nguyentrongkhoa/H-Andy/Pictures/compliant_finger_8.png

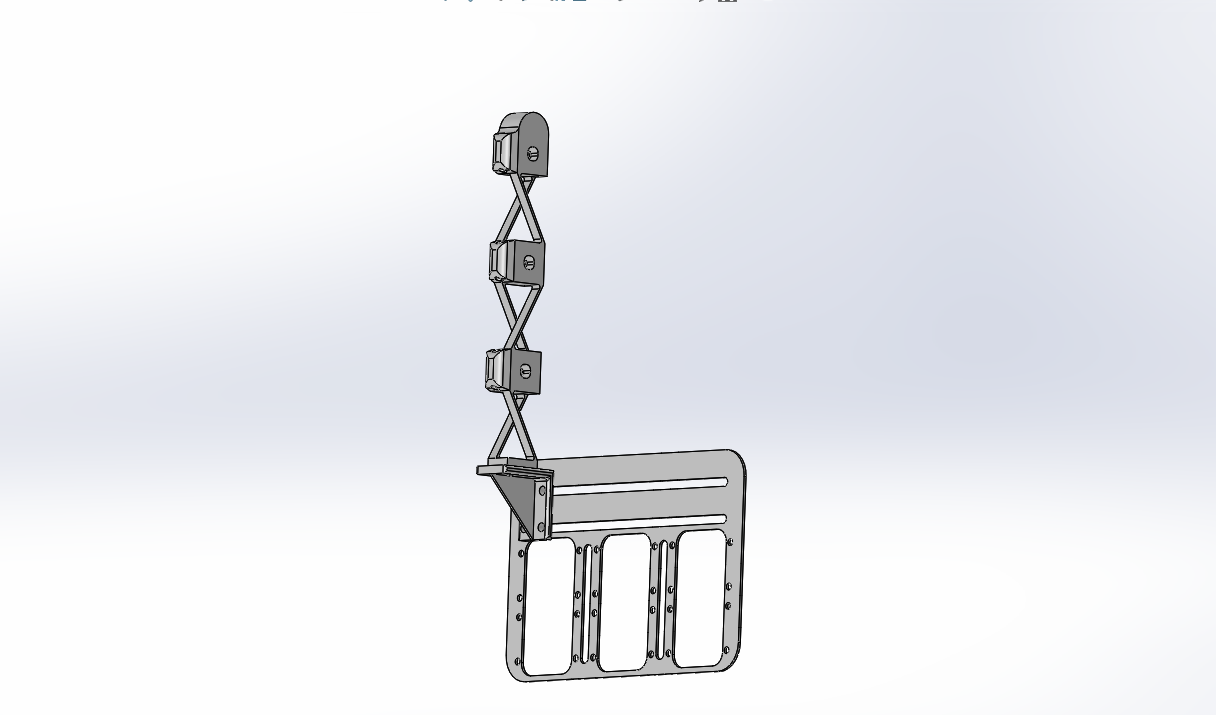
Pictures/compliant_finger_8.png
