nguyentrongkhoa/H-Andy/Pictures/finger_18.05.png

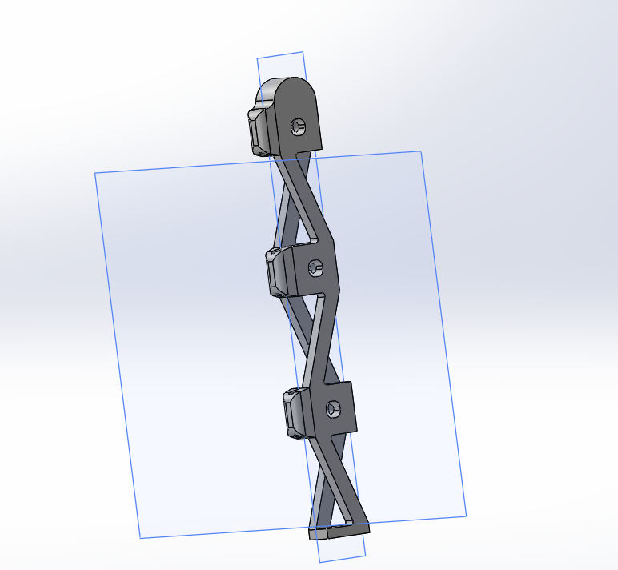
Pictures/finger_18.05.png
