nguyentrongkhoa/H-Andy/Pictures/hand_18.05.png

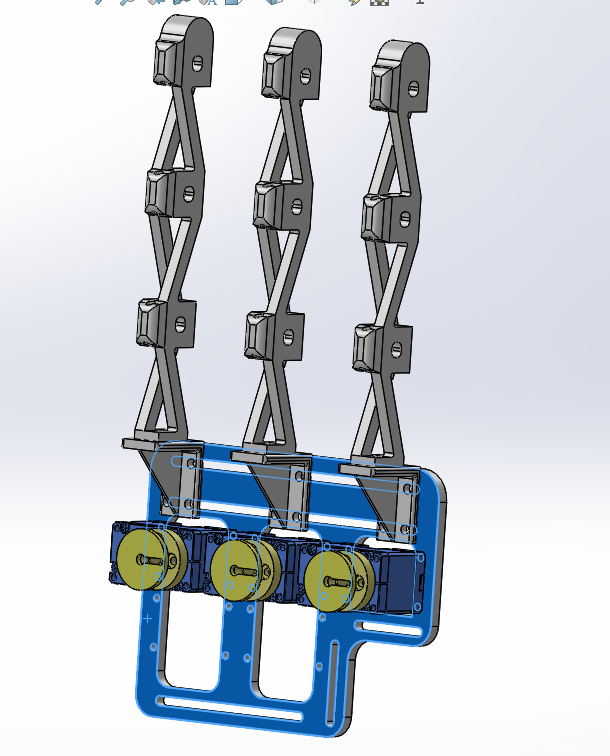
Pictures/hand_18.05.png
