nguyentrongkhoa/H-Andy/Pictures/palm_18.05.png

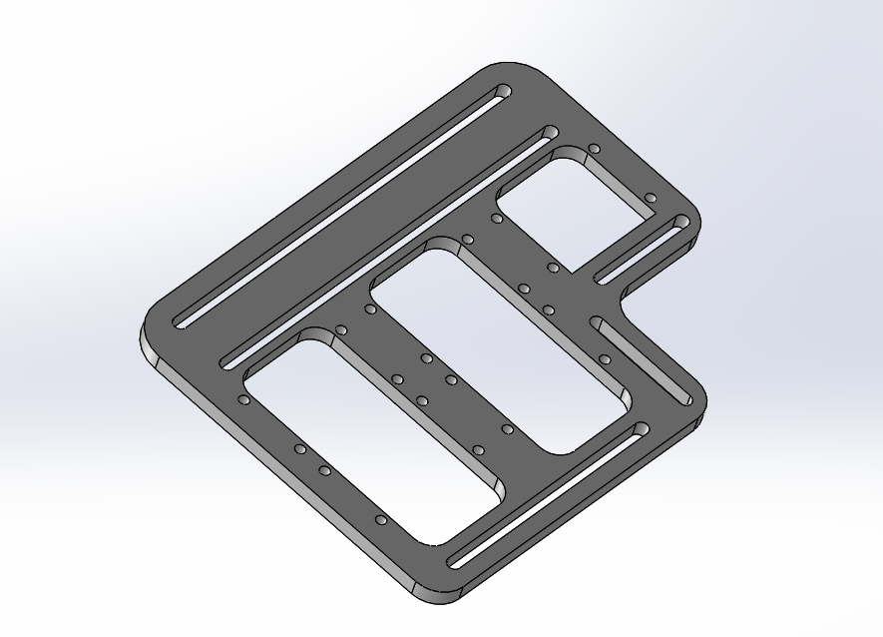
Pictures/palm_18.05.png
