nguyentrongkhoa/H-Andy/U2D2_Powerhub  Gehäuse.SLDASM

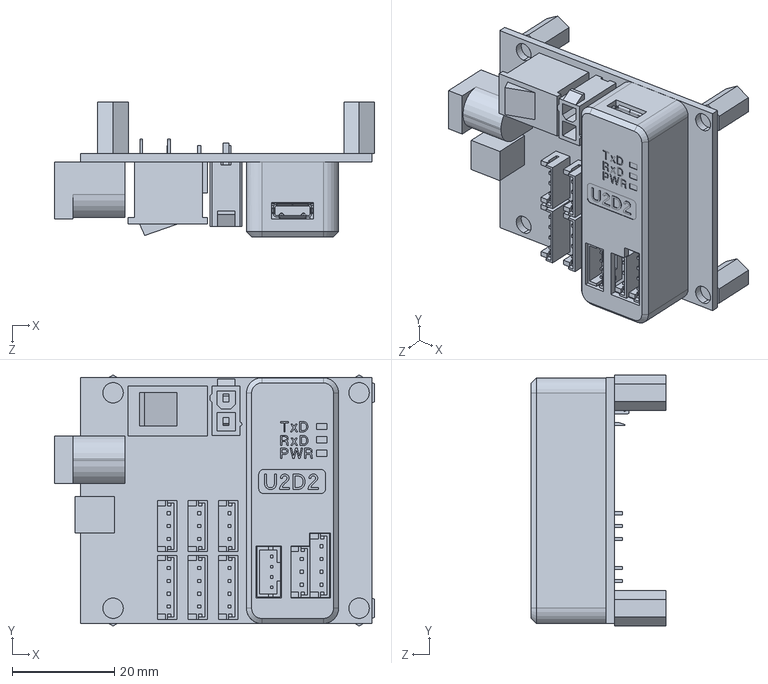
[picture p5: CAD file, 2025-06-07]
U2D2_Powerhub Gehäuse.SLDASM
62.5 x 49.0 x 26.3 mm
