nguyentrongkhoa/H-Andy/3D Printing/5mm_finger.3MF

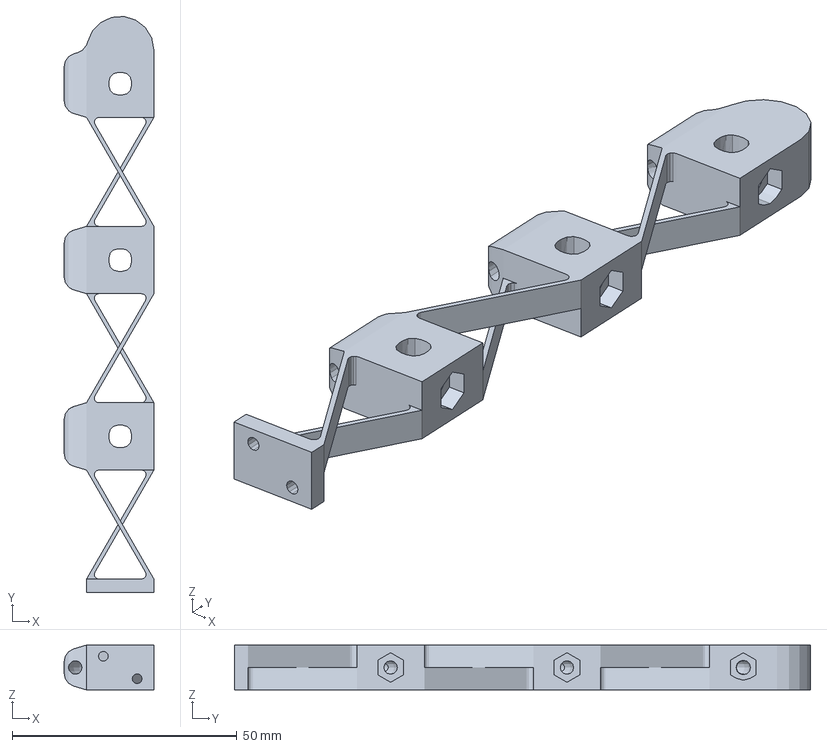
[picture p6: CAD file, 2025-06-07]
3D Printing/5mm_finger.3MF
20.0 x 128.2 x 10.0 mm
