nguyentrongkhoa/H-Andy/motor_spur_gear_m2_pa20_N18.SLDPRT

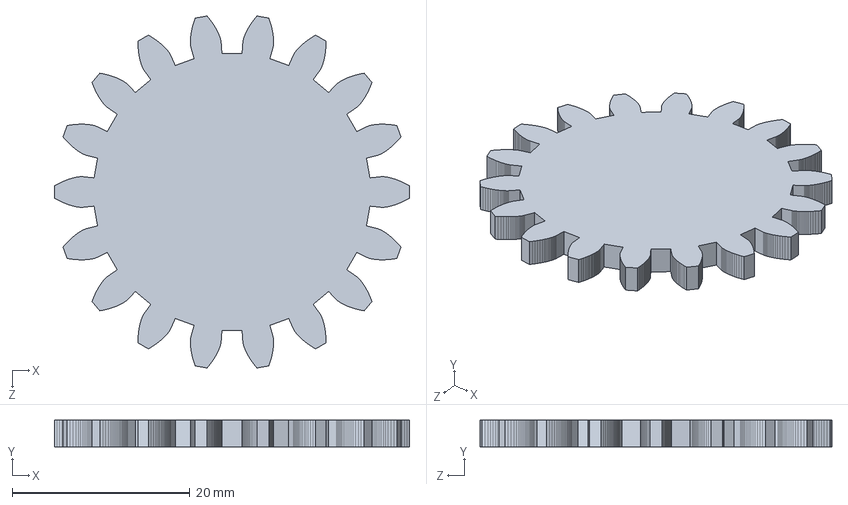
[picture p7: CAD file, 2025-06-08]
motor_spur_gear_m2_pa20_N18.SLDPRT
40.0 x 3.00 x 39.6 mm
