nguyentrongkhoa/H-Andy/motor_spur_gear_m2_pa20_N12.SLDPRT

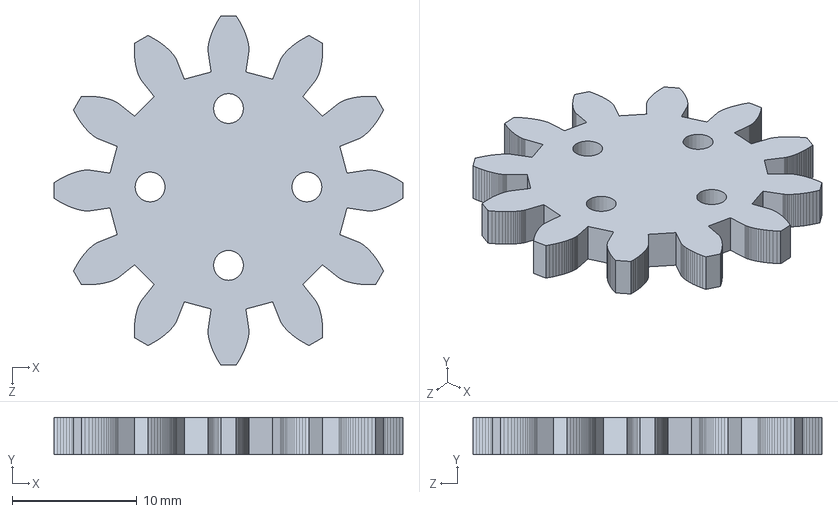
[picture p8: CAD file, 2025-06-08]
motor_spur_gear_m2_pa20_N12.SLDPRT
28.0 x 3.00 x 28.0 mm
