nguyentrongkhoa/H-Andy/motor_spur_gear_m2_pa20_N24.SLDPRT

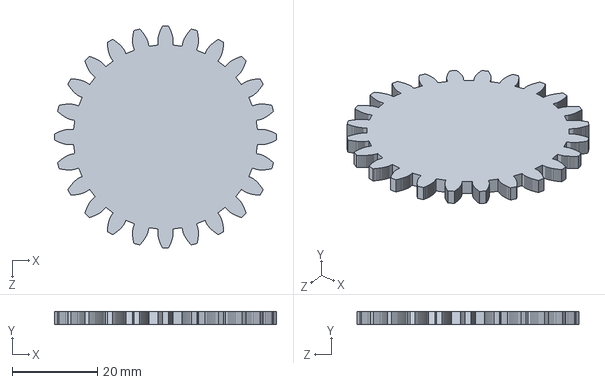
[picture p9: CAD file, 2025-06-08]
motor_spur_gear_m2_pa20_N24.SLDPRT
52.0 x 3.00 x 52.0 mm
