nguyentrongkhoa/H-Andy/palm_1.SLDPRT

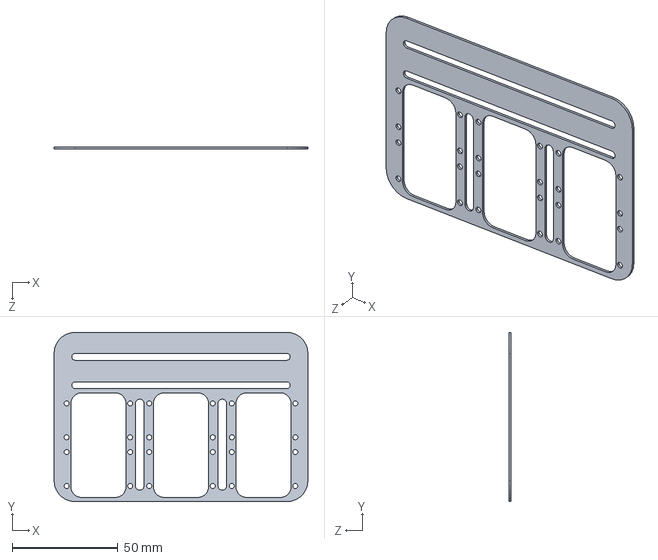
[picture p10: CAD file, 2025-06-07]
palm_1.SLDPRT
120.0 x 80.0 x 1.00 mm
