nguyentrongkhoa/H-Andy/motor_pulley.SLDPRT

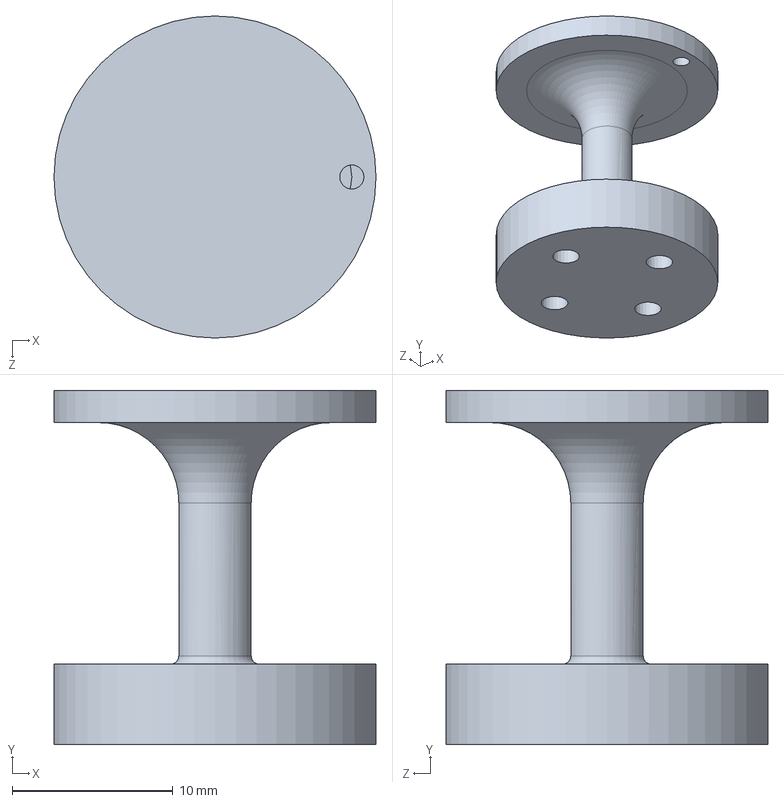
[picture p11: CAD file, 2025-06-07]
motor_pulley.SLDPRT
20.0 x 22.0 x 20.0 mm
