nguyentrongkhoa/H-Andy/thumb.SLDPRT

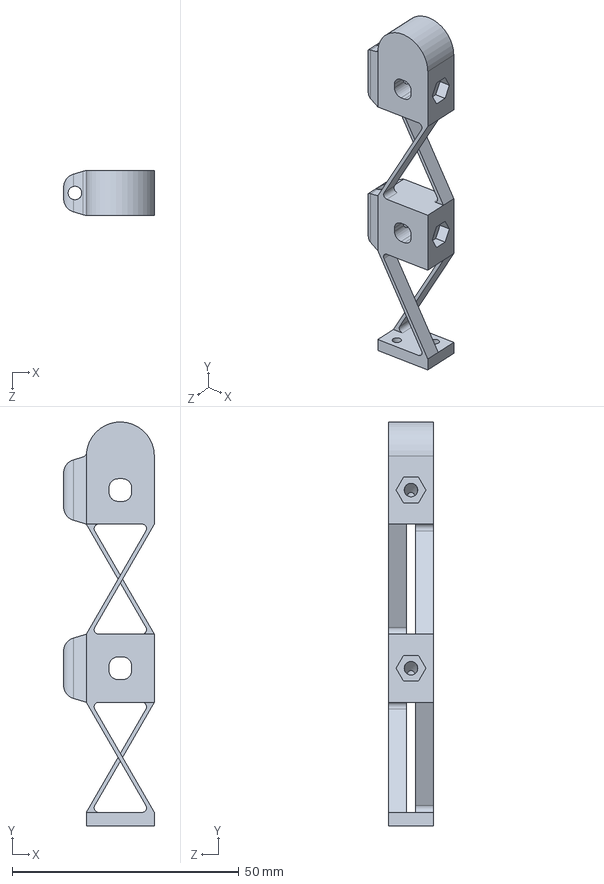
[picture p12: CAD file, 2025-06-07]
thumb.SLDPRT
20.0 x 89.0 x 10.0 mm
