nguyentrongkhoa/H-Andy/thumb_bracket.SLDPRT

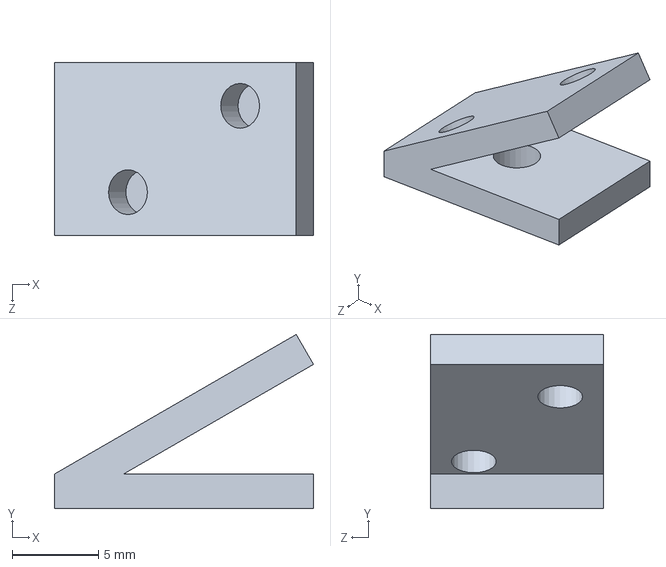
[picture p14: CAD file, 2025-06-07]
thumb_bracket.SLDPRT
15.0 x 10.1 x 10.0 mm
