nguyentrongkhoa/H-Andy/compliant_finger_9.SLDPRT

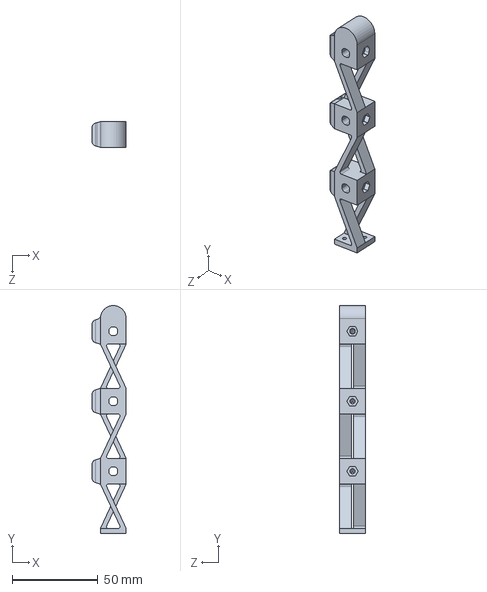
[picture p15: CAD file, 2025-06-07]
compliant_finger_9.SLDPRT
20.0 x 132.7 x 15.0 mm
