nguyentrongkhoa/H-Andy/RUDERHORN.SLDPRT

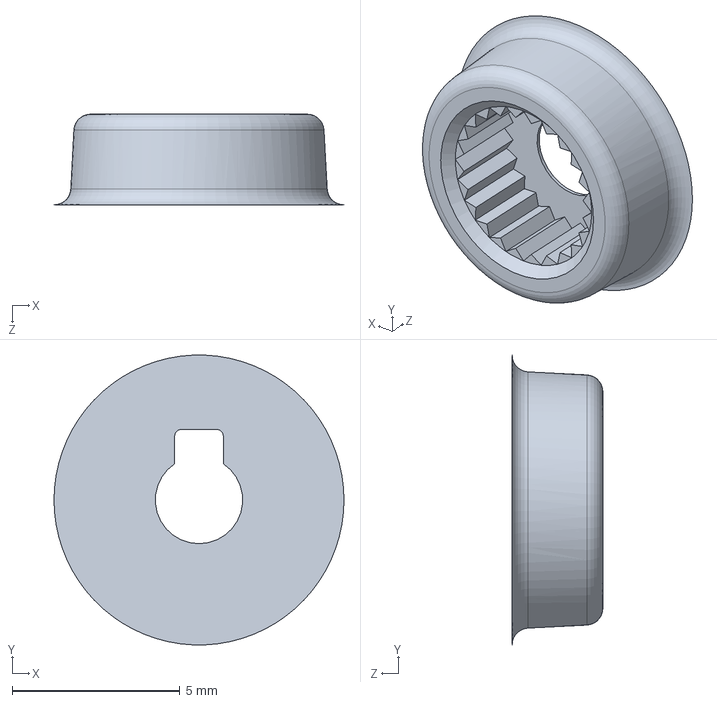
[picture p16: CAD file, 2025-06-07]
RUDERHORN.SLDPRT
8.63 x 8.62 x 2.70 mm
