nguyentrongkhoa/H-Andy/compliant_finger_2.SLDPRT

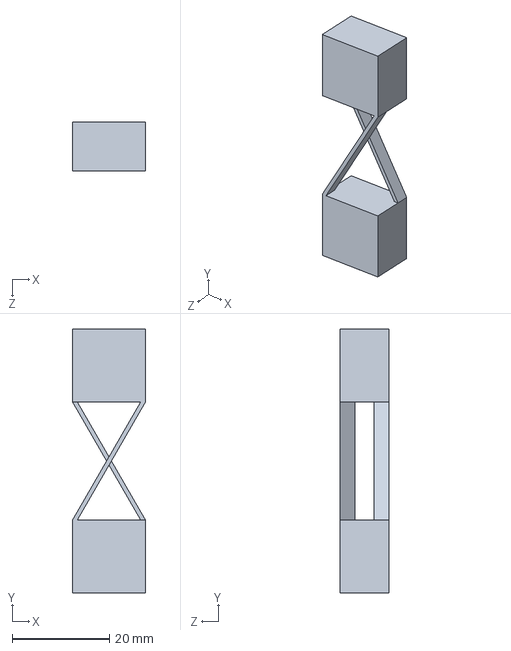
[picture p17: CAD file, 2025-06-07]
compliant_finger_2.SLDPRT
15.0 x 54.2 x 10.0 mm
