nguyentrongkhoa/H-Andy/compliant_finger_7.SLDPRT

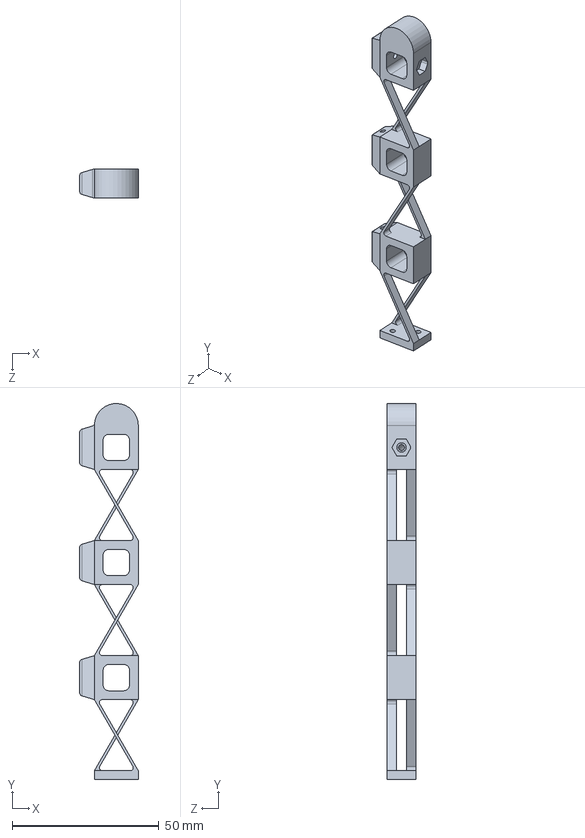
[picture p18: CAD file, 2025-06-07]
compliant_finger_7.SLDPRT
20.0 x 128.2 x 10.0 mm
