nguyentrongkhoa/H-Andy/compliant_finger_6.SLDPRT

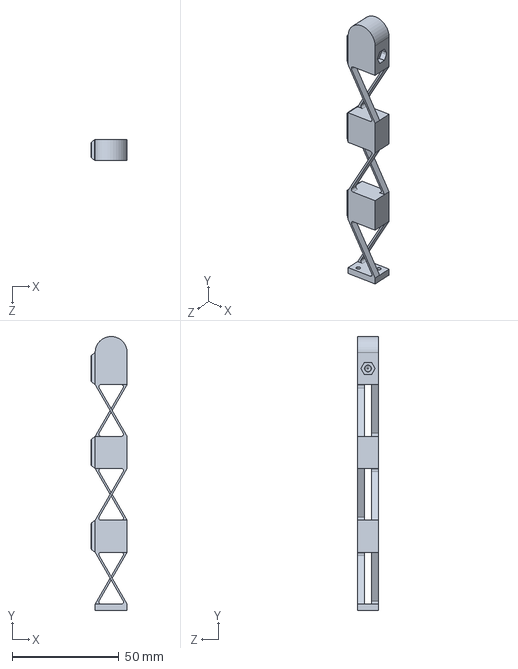
[picture p20: CAD file, 2025-06-07]
compliant_finger_6.SLDPRT
17.0 x 128.2 x 10.0 mm
