nguyentrongkhoa/H-Andy/Gehäuse-1.SLDPRT

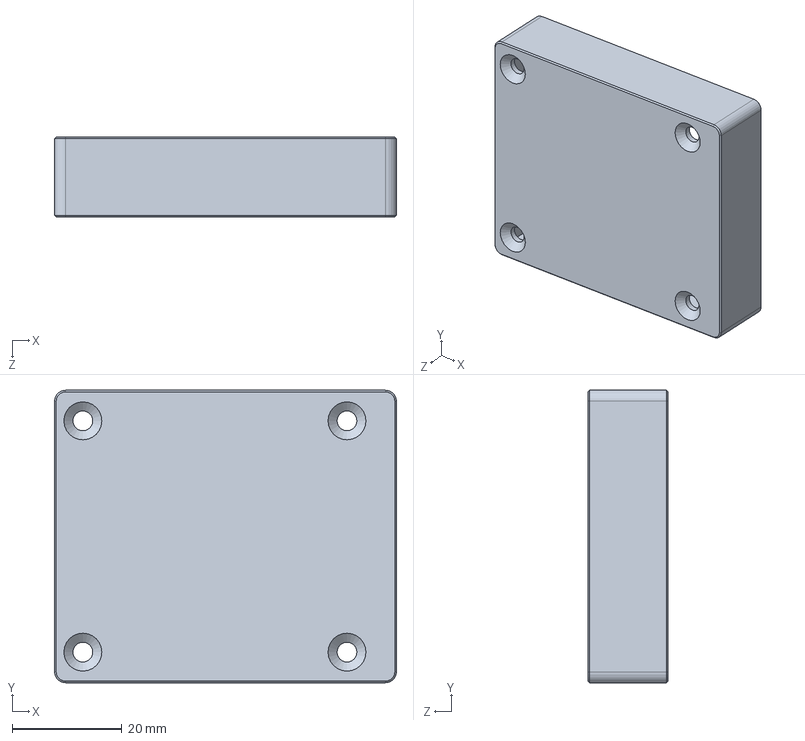
[picture p21: CAD file, 2025-06-07]
Gehäuse-1.SLDPRT
62.2 x 53.2 x 14.6 mm
