nguyentrongkhoa/H-Andy/compliant_finger_8.SLDPRT

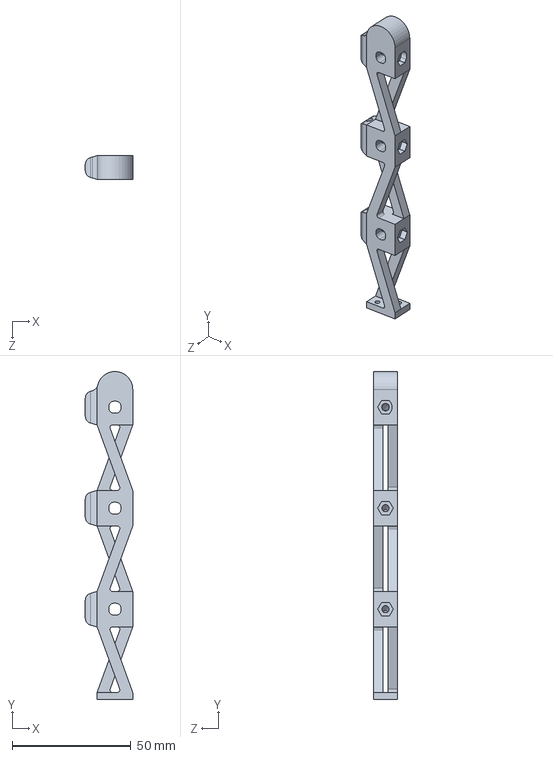
[picture p22: CAD file, 2025-06-07]
compliant_finger_8.SLDPRT
20.0 x 137.9 x 10.0 mm
