nguyentrongkhoa/H-Andy/compliant_finger_4.SLDPRT

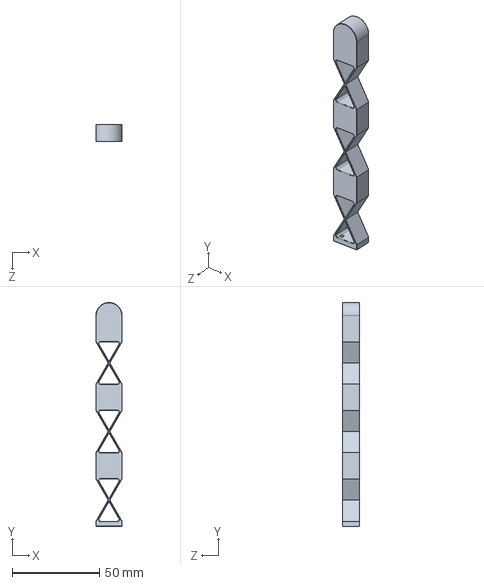
[picture p23: CAD file, 2025-06-07]
compliant_finger_4.SLDPRT
15.0 x 128.2 x 10.0 mm
