nguyentrongkhoa/H-Andy/palm_2.SLDPRT

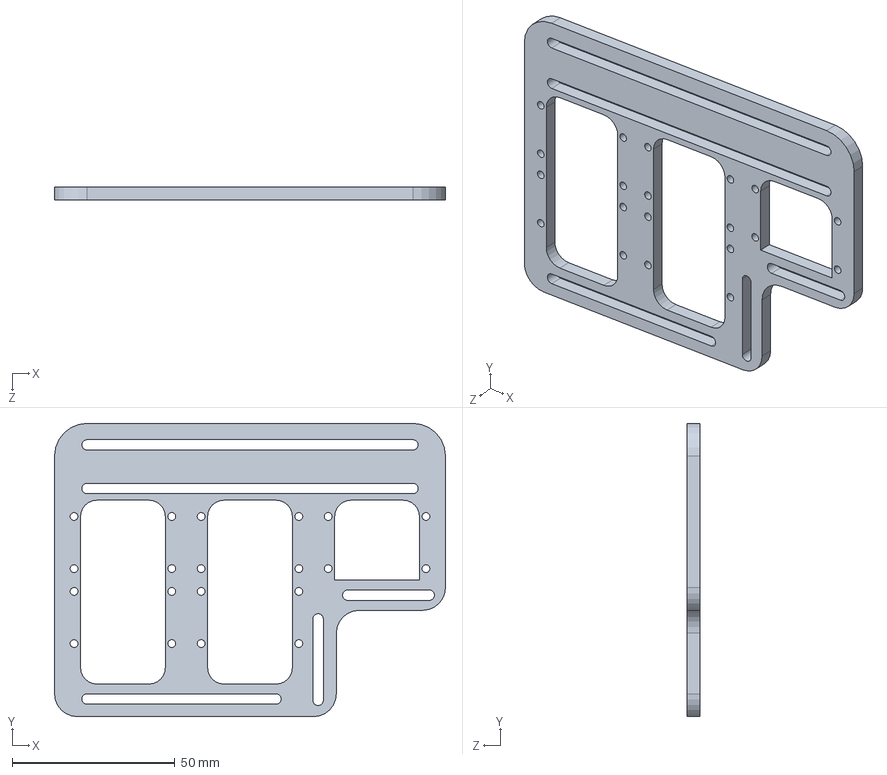
[picture p24: CAD file, 2025-06-07]
palm_2.SLDPRT
120.0 x 90.0 x 4.00 mm
