nguyentrongkhoa/H-Andy/butterfly_flexure_finger.SLDPRT

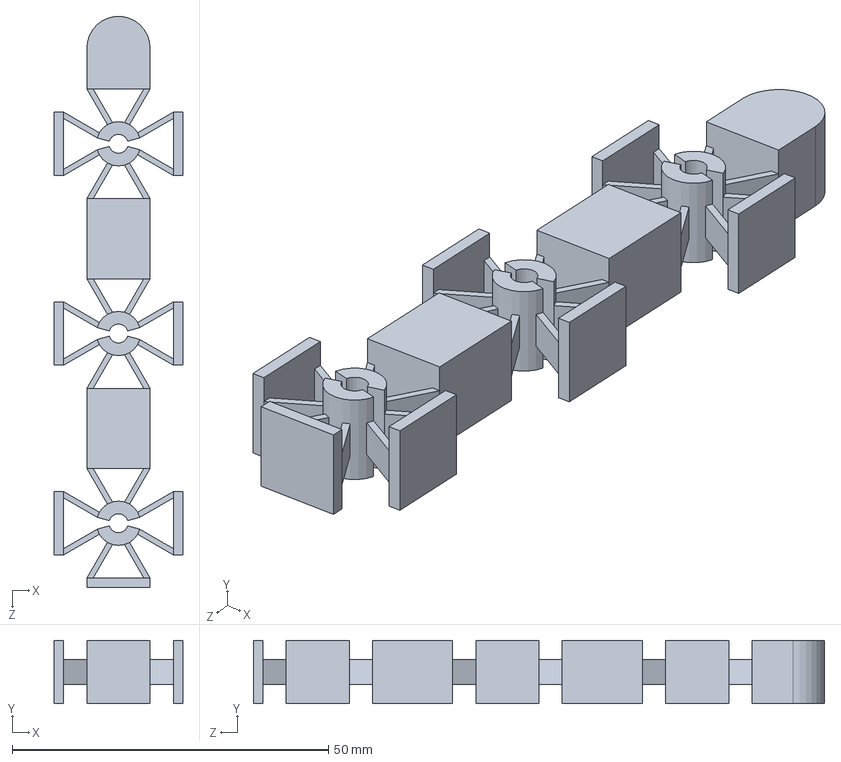
[picture p25: CAD file, 2025-06-07]
butterfly_flexure_finger.SLDPRT
20.3 x 10.0 x 90.3 mm
