nguyentrongkhoa/H-Andy/thumb_to_palm.SLDPRT

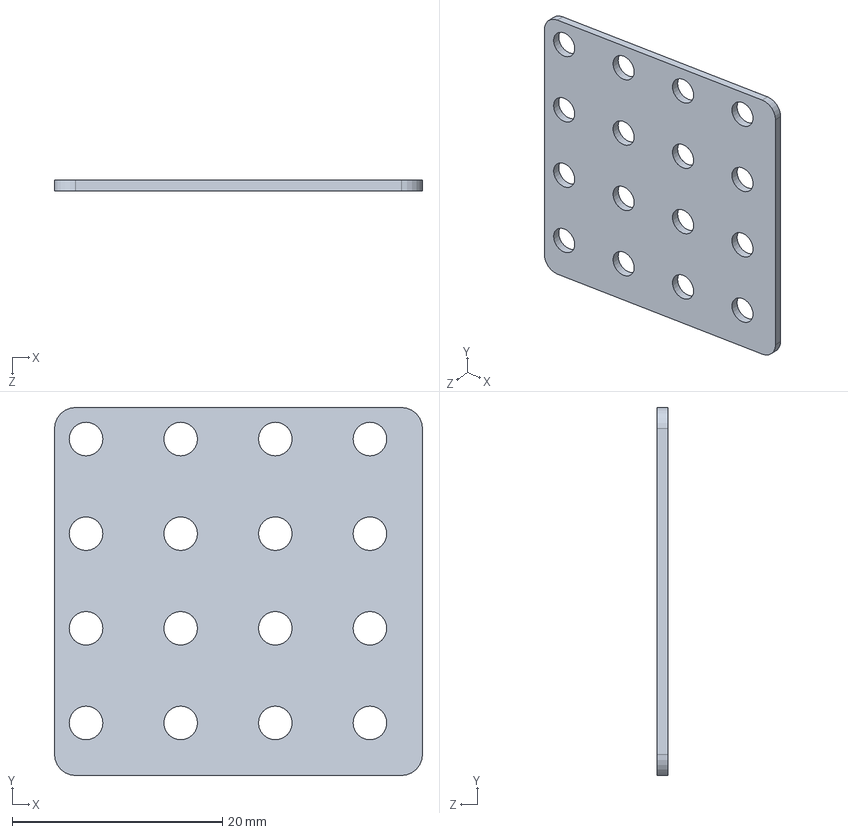
[picture p26: CAD file, 2025-06-07]
thumb_to_palm.SLDPRT
35.0 x 35.0 x 1.00 mm
