nguyentrongkhoa/H-Andy/compliant_finger_1.SLDPRT

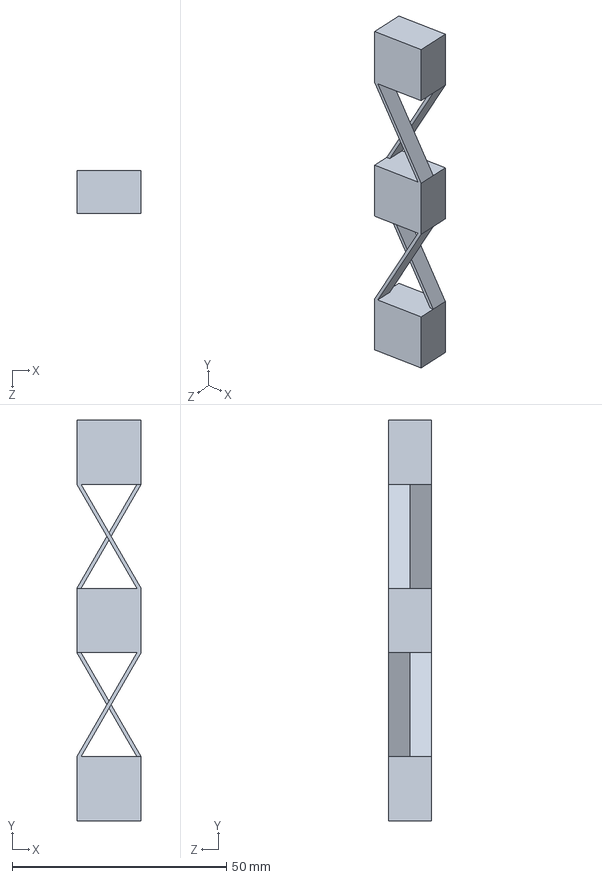
[picture p27: CAD file, 2025-06-07]
compliant_finger_1.SLDPRT
15.0 x 93.5 x 10.0 mm
