nguyentrongkhoa/H-Andy/hand.SLDASM

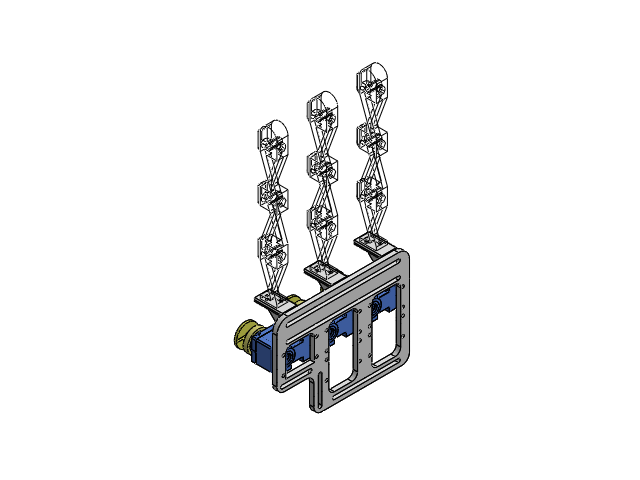
[picture p28: CAD file, 2025-06-07]
hand.SLDASM
compliant_finger_8 x 3
palm_2
finger_bracket x 3
DC15_A01_CASE_M_DUMMY.step x 3
DC15_A01_CASE_F_DUMMY.step x 3
DC15_A01_CASE_B_DUMMY.step x 3
DC15_A01_HORN_DUMMY.step x 3
DC15_A01_LED_CAP2_DUMMY.step x 3
PHS_1_7X20_5_DC10.step x 12
BTS2_M2_6X8.step x 3
B3B-EH.step x 6
motor_pulley_bottom x 3
motor_pulley_top x 3
