nguyentrongkhoa/H-Andy/XL-330.SLDASM

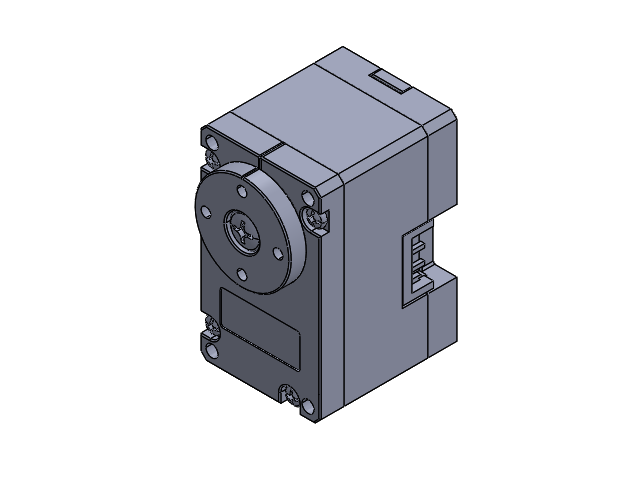
[picture p29: CAD file, 2025-06-07]
XL-330.SLDASM
DC15_A01_CASE_M_DUMMY.step
DC15_A01_CASE_F_DUMMY.step
DC15_A01_CASE_B_DUMMY.step
DC15_A01_HORN_DUMMY.step
DC15_A01_LED_CAP2_DUMMY.step
PHS_1_7X20_5_DC10.step x 4
BTS2_M2_6X8.step
B3B-EH.step x 2
