nguyentrongkhoa/H-Andy/finger_bracket.SLDASM

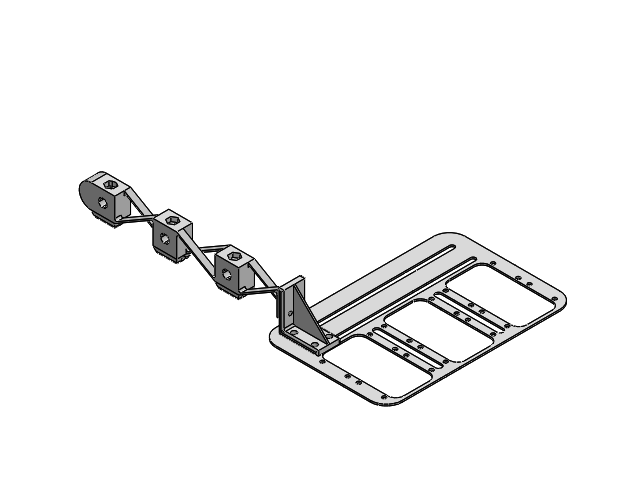
[picture p30: CAD file, 2025-06-07]
finger_bracket.SLDASM
finger_bracket
compliant_finger_8
