nguyentrongkhoa/H-Andy/(list of files, cad)

Other CAD files:
ROBOTIS_U2D2_Power_Hub_Board.SLDPRT
3D Printing/butterfly_flexure_finger.3MF
3D Printing/compliant_finger_8.3MF
3D Printing/compliant_finger_9.3MF
3D Printing/finger_bracket.3MF
3D Printing/motor_pulley.3MF
3D Printing/palm_2.3MF
3D Printing/thumb.3MF
3D Printing/thumb_bracket.3MF
3D Printing/thumb_to_palm.3MF
finger_bracket.SLDPRT
