nguyentrongkhoa/H-Andy/(commit log)

2025-06-07 Copy all files to Tom branch
    [5mm_finger.3MF, Gehäuse-1.SLDPRT, ROBOTIS_U2D2_Power_Hub_Board.SLDPRT, RUDERHORN.SLDPRT, U2D2_Powerhub Gehäuse.SLDASM, XL-330.SLDASM, butterfly_flexure_finger.3MF, butterfly_flexure_finger.SLDPRT]
2025-06-08 Added gears for dynamixel motors
    [motor_pulley_bottom.SLDPRT, motor_pulley_top.SLDPRT, motor_spur_gear_m2_pa20_N12.SLDPRT, motor_spur_gear_m2_pa20_N18.SLDPRT, motor_spur_gear_m2_pa20_N24.SLDPRT, test_butterfly_flexure_finger.SLDPRT]
